marcrdavis/ArduinoTITO-PlayerTracking/Arduino TITO and TITO Deluxe Project - Documentation.pdf

June 23, 2026 – Version 4.0.20260623

# SETUP GUIDE

# Arduino TITO and TITO Deluxe

# Marc R. Davis

## OVERVIEW This is a TITO-only version of my larger project; re-designed for the Arduino UNO and as a compatible upgrade to the BETTORSlots TITO and

TITO Deluxe hardware.

## Project: https://github.com/marcrdavis/ArduinoTITO-PlayerTracking

ARDUINO TITO AND TITO DELUXE | 2

HARDWARE REQUIRED

Arduino UNO (or BETTORSlots TITO/Deluxe Board) https://www.amazon.com/gp/product/B01EWOE0UU

W5100 Ethernet Shield (if you want to use the Deluxe features) https://www.amazon.com/gp/product/B00AXVX5D0/

MAX3232 Serial port (or compatible)
https://www.amazon.com/gp/product/B083L99CGZ

1’ USB Cable
https://www.amazon.com/1-feet-USB-2-0-Printer-Device-Cable-Black-Type-A-Male-Type-B-Male-Plug-A-Male-to-B-Male-High/dp/B000JC00UO (https://www.amazon.com/1-feet-USB-2-0-Printer-Device-Cable-Black-Type-A-Male-Type-B-Male-Plug-A-Male-to-B-Male-High/dp/B000JC00UO)

Four 2” DuPont M-F jumper wires

CAT5 cable long enough to reach from your network jack to inside the game cabinet https://www.amazon.com//dp/B07QXNWRWJ (https://www.amazon.com/dp/B07QXNWRWJ)

Serial cable to connect to game

- For IGT Games: 5-pin Dupont to Male DB9 Serial pigtail (I reused the one from the BETTORSlots TITO board)
- https://www.amazon.com/gp/product/B081GJR1MN

5 Watt or greater USB Power Brick

3D printed case for Arduino (or something to protect Arduino from shorting-out on metal in cabinet)

Compatible slot machine

- Tested on IGT S2000/GameKings/AVP, Bally, WMS and Konami machines; will probably work on others based on the SAS 6.x protocol; you will need a compatible cable to connect to the serial port on the machine

SOFTWARE REQUIRED

Latest version of Arduino IDE https://www.arduino.cc/en/software

BEFORE YOU BEGIN

These instructions assume familiarity with electronics, coding and slot machine configurations. If you are new to any of these then this project may not be for you. My instructions were not written for beginners. You may damage your game or the Arduino/TITO hardware if you do not understand what you are doing.

WIRING (skip if reusing BETTORSlots hardware)

- The Ethernet Shield attaches to the Arduino UNO via the built-in pin headers [Deluxe Only]
- The Serial board needs to be wired as follows:
Serial | Arduino
VCC | 5V
RXD | Data Pin 0
TXD | Data Pin 1
GND | GND

You will need to power the Arduino board from the Accessory Outlet in the base of the slot machine using a USB power brick (5W or greater).

- Do not power the board from any built-in USB port on the game – it will not provide enough power

You will also need to run a CAT5 cable into the cabinet for the network.

INITIAL SETUP

- Assumes you have the Arduino IDE setup, the board and COM port settings are correct
- [Deluxe Only] The following libraries and versions are required:
- Ethernet* (latest)
- SPI* (latest)
- SD* (latest)

*Can be downloaded via the Arduino IDE Library Manager

- IMPORTANT: Before you program the Arduino, you must temporarily disconnect the two wires on serial pins 0 and 1 because the serial connection is shared between the USB and the 9-pin connector
- Connect the board to your computer via USB and load the ArduinoTITOV4 or ArduinoTITODeluxeV4 sketch as appropriate
- [Deluxe Only] The SD card is optional, but highly recommended; when present the board will attempt to read its configuration from the SD card. If the config.txt file is not present or if settings are missing the hard-coded defaults will be used.
- If you want to use the web UI then the SD card is required. Alternatively, you could control the machine from the Game Manager Windows app.
- [Deluxe Only with SD card] Format the MicroSD Card as FAT32
- [Deluxe Only with SD Card] Edit the included config.txt file with your settings and preferences; then copy it and the index.htm file to the SD card; see the Arduino TITO and Player Tracking Project - File Formats.txt for details on the supported parameters
- If you are using the TITO Only sketch or the Deluxe without an SD card, you must modify the following settings in the sketch before you download it to the Arduino UNO:
- ChangeToCredits – set to 1 to add credits via the Service/Change button
- changeCredits – set to the number of credits to add on each push of the Service/Change button
- [Deluxe Only] noSDCard – Set to 1 to disable the SD card, if present
- [Deluxe Only] mac – set a unique mac address for the Ethernet board; only necessary if you will be deploying more than one Arduino TITO Deluxe R3 board on your network
- [Deluxe Only] ip – set a unique IP address for your network
- Download the sketch to the Arduino; wait until complete
- Unplug the Arduino from the PC
- IMPORTANT: Re-attach the serial connections on pins 0 and 1
- Mount the hardware into the slot machine’s lower cabinet
- Connect the board to the game’s serial port using the DB9-to-DuPont cable or existing compatible cable
- [Deluxe Only] Connect the CAT5 Ethernet cable from your network switch to the Arduino
- Connect the USB power to the machine’s accessory outlet
- Power on the machine and test
- Assumes you are replacing an existing TITO board or have already setup your machine per the instructions later in this document

UPGRADING BETTORSLOTS HARDWARE

This software was designed to allow owners of the BETTORSlots TITO and TITO Deluxe hardware the option of upgrading their software to The Arduino TITO project.

WARNING! If you choose to upgrade your BETTORSlots board to The Arduino TITO Project software you do so at your own risk. The process is irreversible and you will lose any support, if any is still available, from the original vendor. I have only tested this on the few BETTORSlots boards I have in my possession.

The procedure is identical to the INITIAL SETUP process above; if you have a BETTORSlots Deluxe board then use the ArduinoTITODeluxe sketch; otherwise use the ArduinoTITO sketch.

REMOTE ACCESS (Deluxe Version Only)

The web interface allows you to control various aspects of your game by using a web browser.

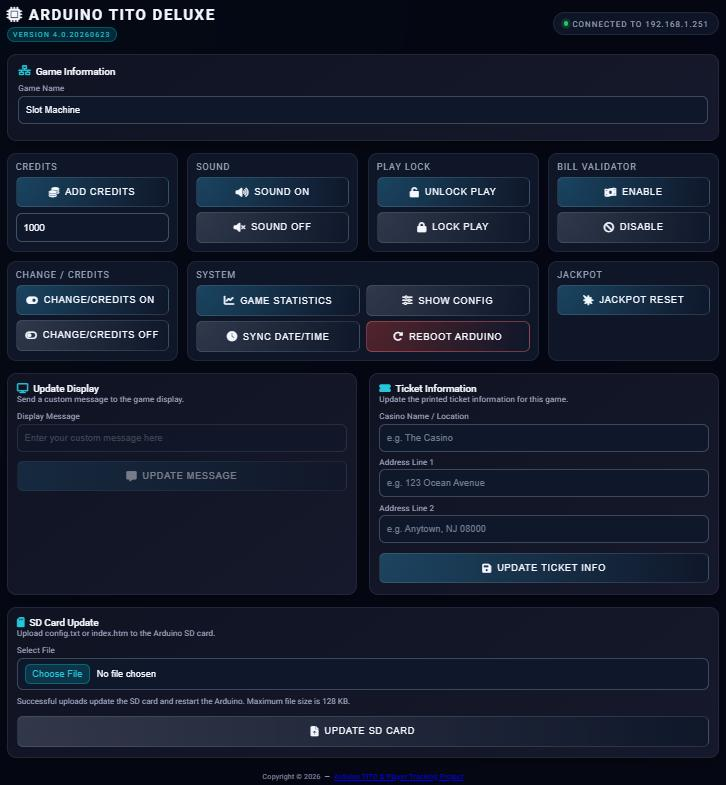
[picture p9: figure]

Most functions are self-explanatory; The Change/Credits feature allows you to enable adding credits by pressing the Change (or Service) button. The number of credits added on each press is set in the sketch (or the config file) prior to loading it onto the Arduino.

The Update Ticket Info option allows you to change the information printed on the cash-out ticket.

Some features are not available on all games or versions of the Arduino TITO board.

CONFIGURING YOUR IGT MACHINE (S2000/GameKing)

Before getting started with setting up your IGT machine for TITO please ensure your Bill Validator is working correctly and your Ticket Printer can print clear and legible tickets. You will also need a Keychip appropriate for your type of machine. These instructions assume familiarity with the Keychip process. Note – keychips and menu option locations vary from model-to-model. Please consult your IGT user manual or me if you have questions.

1. Clear any credits off your machine
2. Keychip your machine
3. Once in the Keychip Menu, ensure your Denomination, Devices, Limits and Game settings are as you want them
4. Setup the Comm Options as follows
a. IGT SAS Primary Channel = Channel 3
b. SAS Secondary = Off
c. Bally Miser = Off
d. Progressive Link = 7
e. WAMM 1.0 = Off
5. Setup the Validation/Redemption Options as follows
a. Validation = System Validation
b. Redemption = SAS Redemption
6. Setup the IGT SAS Options as follows
a. System Bonusing = SAS Legacy
7. Setup the SAS Channel (Primary Channel) Options as follows
a. Address = 1
b. Legacy Bonus = Enabled (X)
c. Validation = Enabled (X)
8. Setup the Machine Terminal Options as follows
a. Voucher Limit Follows = Credit Limit
9. Save all options and make any other changes you wish before pressing Return to Game to exit the keychip menu

Test the game by inserting money and then pressing Cash Out to generate a ticket. The ticket serial number should match the number of credits you inserted. Insert the ticket into the machine, it should accept it for the same number of credits.

CONFIGURING YOUR IGT MACHINE (AVP)

Please see this video for how to configure your AVP Game: https://www.youtube.com/watch?v=JKjyeFQPltA

NOTES AND COMMENTS

- This version was designed to create new TITO-only boards as well as upgrade or reuse existing BETTORSlots TITO and TITO Deluxe boards; if you choose to attempt to upgrade a BETTORSlots board you do so at your own risk and the process is irreversible.

DISCLAIMER

THIS SOFTWARE IS PROVIDED BY THE COPYRIGHT HOLDERS AND CONTRIBUTORS “AS IS” AND ANY EXPRESS OR IMPLIED WARRANTIES, INCLUDING, BUT NOT LIMITED TO, THE IMPLIED WARRANTIES OF MERCHANTABILITY AND FITNESS FOR A PARTICULAR PURPOSE ARE DISCLAIMED. IN NO EVENT SHALL THE COPYRIGHT OWNER OR CONTRIBUTORS BE LIABLE FOR ANY DIRECT, INDIRECT, INCIDENTAL, SPECIAL, EXEMPLARY, OR CONSEQUENTIAL DAMAGES (INCLUDING, BUT NOT LIMITED TO, PROCUREMENT OF SUBSTITUTE GOODS OR SERVICES; LOSS OF USE, DATA, OR PROFITS; OR BUSINESS INTERRUPTION) HOWEVER CAUSED AND ON ANY THEORY OF LIABILITY, WHETHER IN CONTRACT, STRICT LIABILITY, OR TORT (INCLUDING NEGLIGENCE OR OTHERWISE) ARISING IN ANY WAY OUT OF THE USE OF THIS SOFTWARE, EVEN IF ADVISED OF THE POSSIBILITY OF SUCH DAMAGE.

Figure 1 – Mockup

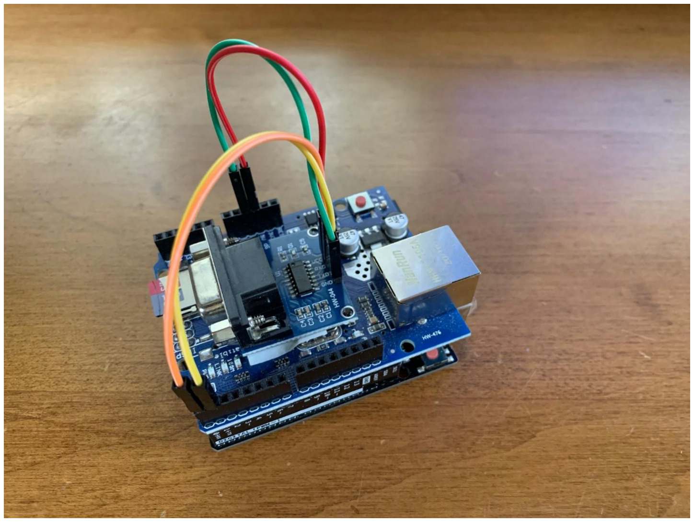
[picture p10: figure]

Example of Deluxe board wiring

FIGURE 2: IGT Serial Cable


IGT S2000/GameKing Serial Pinout

DB9 Male | Signal direction | S2000 J82
3 Receive Data | | 1 Transmit Data
2 Transmit Data | → | 2 Receive Data
5 Signal Ground | --- | 5 Signal Ground

Option: DB9 to Dupont Serial Cable: https://www.amazon.com/gp/product/B081GJR1MN
