marcrdavis/ArduinoTITO-PlayerTracking/(threads)

Thread 2 (2021-01-01):

Unable to TITO

Eddiiie, 2021-01-01:
I must be doing something wrong.

IGT G20, Mars BV

I have BettorTITO working.   Removed it, connected The ArduinoTITO-PlayerTracking System.   Followed the great instructions, created 2 played cards.  Boot up, comes online, insert ticket, long pause, spits ticket out.

Add some bonus credits using the WebUI and/or the RFID card, play a bit, hit cash out, long pause, hand pay.

Here are the logs collected from serial.....

**Ticket in**
```
SAS Event Received: 1F
SAS Event Received: 1F
SAS Event Received: 1F
SAS Event Received: 1F
SAS Event Received: 1F
SAS Event Received: 1F
SAS Event Received: 1F
SAS Event Received: 67
Unable to read data - timeout
Redeeming ticket
SAS Event Received: 51
SAS Event Received: 1F
SAS Event Received: 1F
SAS Event Received: 1F
SAS Event Received: 1F
SAS Event Received: 1F
```

**Ticket Out**
```
Arduino TITO and Player Tracking - Version 2.0 (Dec 22, 2020) By Marc R. Davis
Initializing...
IP address: 192.168.254.99
Initialization complete
Card Inserted
Card ID: 5727C4A6
Card Type: Player
Cardholder: Player1
Player Stats - Games played: 2 Games Won: 2 Games Lost: 0 Total Won: 2600
Reading meters from game
Unable to read data - timeout
Unable to read data - timeout
Unable to read data - timeout
Unable to read data - timeout
Unable to read data - timeout
Unable to read data - timeout
Could not read current stats from game. Player's current session will not be saved.
Ready for play
SAS Event Received: 51
SAS Event Received: 1F
SAS Event Received: 1F
SAS Event Received: 1F
SAS Event Received: 1F
SAS Event Received: 1F
SAS Event Received: 1F
SAS Event Received: 1F
SAS Event Received: 1F
SAS Event Received: 1F
SAS Event Received: 1F
SAS Event Received: 1F
SAS Event Received: 66
SAS Event Received: 57
Unable to read data - timeout
Printing cashout ticket
SAS Event Received: 57
Unable to read data - timeout
Printing cashout ticket
SAS Event Received: 57
Unable to read data - timeout
Printing cashout ticket
SAS Event Received: 57
Unable to read data - timeout
Printing cashout ticket
SAS Event Received: 57
Unable to read data - timeout
Printing cashout ticket
SAS Event Received: 57
Unable to read data - timeout
Printing cashout ticket
SAS Event Received: 57
Unable to read data - timeout
Printing cashout ticket
SAS Event Received: 57
Unable to read data - timeout
Printing cashout ticket
SAS Event Received: 51
SAS Event Received: 51
SAS Event Received: 51
```

marcrdavis, 2021-01-01:
Hi. Double check your Tito settings in the game to my instructions. It’s looks like something is wrong with the coms channel or the serial interface is having problems.

Also... what kind of game and software are you running?

Marc

Sent from my iPad

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

marcrdavis, 2021-01-01:
Took a look at the code and the log you sent; your machine is sending 1F – that is an unexpected (and possibly invalid) value). Normally the active SAS serial channel puts out a ‘heartbeat’ consisting of 0x80 and 0x81, yours seems to be sending 1F – which is not a valid response. A Long Poll of 01,1F by the host would cause the game to return the version number. But I don’t implement that in my code.

I think that the serial channel may be wrong. On Step 4A on Page 5 of the doc make sure the SAS channel is set to 3 and then in step 7A make sure it is set to 1. Then – goto the Diagnostics menu on the machine, open the Comm Channel Analyzer, select Com 3 and look at the data – at idle it should be series of 0x80 and 0x81 … send me a screen shot of what you are seeing there.

Marc

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

Eddiiie, 2021-01-02:
Hi,
My SASHost setup is on COM1.
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

On an AVP you have these daughter cards..  Fibre, RS232, Data Collection, etc.  I have my RS232 board in the slot for COM1.  Is the data exchanged different depending on which port it is coming from?    BettorTITO doesn't seem to care.

Could it be related to time?  There is a note in red that says the Protocol controlling Voucher In/Out will also control clock.

Here are some more screenshots -
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

Granted, there are a couple settings that are not set according to your recommendations.  Such as Progressive (Link 7 is not an option),

Is there a NOOP or something the program can respond to when it gets 1F?       If it was a communication issue wouldnt the other options not work?

marcrdavis, 2021-01-02:
Hi – I have not tested this on an AVP system or anything other than COM 3 – it is based on the same ports as the BETTORSlots board. Can you change your SAS port to COMM3?

Also – what type of game is this? It might help me understand what is going on. Thx

Marc

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

marcrdavis, 2021-01-02:
Well com1 may be correct; is everything setup as in this video: https://www.youtube.com/watch?v=JKjyeFQPltA

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

Eddiiie, 2021-01-02:
I moved to COM3.   In doing so I noticed one of the pins loose on the Serial adapter.   Fixed it and the 1F and 51 61 stuff has gone away.  In fact, the serial monitor window is pretty quiet after initializing and stuff.

Unfortunately, TITO is still not working.
 I swear I'd see a message about validating when inserting a ticket before..?  Now there is nothing.

Looking at the communication output in diagnostics, RX is 80, 81   TX is 0.  Most of the time.    I can't insert a ticket of course.
I DO have a serial port tapper to listen in on the conversation.

Also have WMS and Konami can test on.    It would be easier to move it to the other machines first.

Eddiiie, 2021-01-02:
Yes, everything is setup according to that video.  I can plug the BettorTITO in and TITO works fine.
The machine was setup with BettorTITO before plugging in the ArduinoTITO-PlayerTracking system.

Not sure if I mentioned I went back to COMM1 after testing COMM3.

Lemme try a couple other machines that are setup for BettorTITO in a few.

Eddiiie, 2021-01-02:
Hmmm Same thing on the Konami.
Everything seems to work except TITO.
I will experiment more tomorrow.

Did not test WMS

marcrdavis, 2021-01-02:
The RX is 80, 81 TX 0 is the normal idle state of the comm channel - so that’s good. The serial log on my app should be quiet except for when exceptions are thrown or long poll responses. The Tito commands are well documented and should work fine on your system. You say the other commands are working so that’s good.

This serial tap? What is that? Can you remove it?

Sent from my iPad

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

Eddiiie, 2021-01-02:
The serial tap is not connected.  Was just offering that up if we wanted to capture a ticket insert event and see what is going over the wire.

Will make a new board with TITO Only set to 1 tomorrow.

Where are the tito commands well documented?

Here is the tap -
[Serial Tap](https://www.amazon.com/Black-2-Port-RS232-Passive-Splitter/dp/B00AO9C38E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
)

marcrdavis, 2021-01-02:
If you can capture the ticket in and ticket out data using the working Tito board and send it to me that would be extremely helpful.

Sent from my iPad

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

Eddiiie, 2021-01-02:
Some IO Diag screenshots...
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

Eddiiie, 2021-01-02:
Will grab capture if Ticket In and Out of working tomorrow.
Thank you for your support!!

marcrdavis, 2021-01-02:
Make sure your config is back on COM1 – that appears to be the serial port on the AVP (S2000/GameKings use COM3)

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

marcrdavis, 2021-01-02:
https://studylib.net/doc/25224123/sas-602-protocol-manual

Section 15.7 for the cashout process

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

marcrdavis, 2021-01-02:
I have a theory as to why just the TITO is not working; send me your email address – I want to forward you a newer version of the code for testing. Thanks!

Marc

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

Closed 2021-01-13.

Thread 3 (2021-03-24):

Are you building the currently uploaded code?

jtwine, 2021-03-24:
Both versions of the code (magstripe or RFID) appear to have bugs that will prevent building _out of the box,_ I thought I was looking at a library/version issue, but there is code that just contains errors.  The `waitForResponse` function is a good example:

```
byte waitForResponse(byte & waitfor, byte * ret, int sz)
{
  byte responseBytes[sz - 2];
  int wait = 0;

  while (Serial1.read() != waitfor && wait < 3000) {
    delay(1);
    wait += 1;
  }

  if (wait >= 3000) {
    Serial.println(F("Unable to read data - timeout"));
    memset(ret, 0, sz);
    sasError = true;
    return ret;
  }

  Serial1.readBytes(responseBytes, sizeof(responseBytes));
  ret[0] = {0x01};
  ret[1] = waitfor;
  memcpy(ret + 2, responseBytes, sizeof(responseBytes));

  return ret;
}
```

The parameter `sz` is not constant and cannot be used to stack-allocate the `responseBytes` array.  The `ret` parameter is of type `byte*` but the code is trying to return it instead of a `byte`.  (That return value is not being used, anyway.)

There are other similar methods that look more like pesudocode than working C/C++.  In `setupPlayerMessage` this if statement is present: ``` if (playerComps>1 and !skipBuffer)``` - note the ```and``` instead of ```&&```.

Was there some post-download or pre-compile step that I need to perform that I missed?  Or was this just some accidental upload?

Thanks!

Peace!

-=- James.

marcrdavis, 2021-03-24:
Hi James – Hmm – you might be right about the setupPlayerMessage code – but it is compiling and working on my side – very odd. I will fix that.

The waitForResponse code is working fine though and the code does compile.

You will get compile warnings (if you have them enabled) but the code will compile fine. I have had multiple folks testing both versions for a few weeks now on different games and everything has been fine.

Marc

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

marcrdavis, 2021-03-24:
Regarding the waitForResponse code; sz is not a constant; the responseBytes array is sized differently depending on the size of the input array, less two bytes.

Yes - the return is not being used; It could probably be rewritten more elegantly. That function went through several revisions and I may have just left the declaration unmodified.

jtwine, 2021-03-25:
Can you tell me which environment/toolchain you are using to build this?  Whichever one is compiling the code as-is correctly?  (Unless I missed it in the Wiki/Readme/Docs?)

Thanks!

Peace!

-=- James.

marcrdavis, 2021-03-25:
I’m using the Arduino IDE version 1.8.13;

Be sure to update your \Libraries folder with the modified libraries included in the zip file.

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

jtwine, 2021-03-25:
OK - I see what my problem is.  A non-constant array size (VLA) is an _optional_ feature of C11 that is supported by GCC but not all compilers.   That is why that code was tripping me up.  I would have implemented the same kind of behavior using `alloca(...)`, which is not available on all platforms, but this is essentially the same thing.

This, BTW, is the same reason `and` works in the `if` expression - `and` is an alternative token for `&&` that is supported by some C++ compilers (like GCC).

Thanks and sorry for my confusion.

Peace!

-=- James.

marcrdavis, 2021-03-25:
I’m going to cleanup the warnings in the next release. Thx

Marc

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

Closed 2021-03-25.

Thread 5 (2021-12-05):

Konami Support?

samm329b, 2021-12-05:
So far I have tried this out with WMS, Bally, and IGT having no issues, but the unit does not work with konami? Any chance you plan to add support for Konami?

marcrdavis, 2021-12-05:
Hi samm329b - As I don't own a konami it would be hard to test and develop for. Most devices based on the SAS V6 protocol should work; I am guessing Konami is different. If there is any documentation on the protocol they are using I'd be happy to take a look.

marcrdavis, 2021-12-05:
I have reports that is is working with Konami K2V, KP3 and Selixicon.

samm329b, 2021-12-06:
Hello and thanks for the response. I have it plugged into a Konami k2v unit I’m testing with, I turned on the tilt mode for the communications when the credits were not adding, once I turned on the comm tilt about ever 3 seconds like clock work the machine would beep (like a door open beep) and the unit would said lost comm to the host. I have moved the unit over to a few other cabinets to confirm the tito is working fine, so I figured it had to be something within the delay commands in the code, I adjusted them and each time the same result, no beeping just a solid communication with host lost, so I reverted back to the original setting, and I’m back to where I started.

samm329b, 2021-12-06:
I’d like to tell you the fix… smh. I had a bad ground in my Konami cable to the backplane. Works like a charm!

marcrdavis, 2021-12-06:
Cool - thanks for letting me know; glad you got it working!

Closed 2021-12-06.

Thread 6 (2022-01-21):

Arduino UNO SD Fail

josnav, 2022-01-21:
Hi!!! Testing your code ArduinoTITODeluxe, I got "Failed to read config.txt". If I remove code and let more free memory, then it reads config.txt.
I'm using Arduino Uno R3...

Can you export that sample to Mega?

Thanks

marcrdavis, 2022-01-23:
HI - That code was tested and is working with the R3; running it on 3 devices right now; if you are running out of memory then one of two things probably happened - you added code or one or more included libraries are not at the right versions; example - the Ethernet library must be set to version 1.0.4 (page 4 of doc) otherwise there is insufficient memory for the sketch.

The deluxe sketch has virtually no free ram left; if you are looking for something to play with or you want just the TITO functionality on the MEGA, then please use my other sketch in the main project and then you can use the onlyTITO flag to disable the player tracking stuff.

Marc

Closed 2022-01-25.

Thread 7 (2022-11-08):

Qué tal si tratamos de este proyecto adaptarlo a una esp32?

juanclavel, 2022-11-08:

marcrdavis, 2022-11-15:
I am considering it.

juanclavel, 2022-11-15:
thank you very much it would be easier to carry out this excellent project

Obtener Outlook para iOS<https://aka.ms/o0ukef>
________________________________
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

Closed 2022-11-15.

Thread 8 (2023-02-28):

SAS adapter?

philfry9, 2023-02-28:
Hi Marc,

Thanks for sharing this project. I just acquired my first machine and am in the process of getting this setup now.
I think I have everything set with one exception. The machine did not have BS-TITO previously. I have the recommended serial connector connected to the Arduino. I would like to build an adapter from the serial output of the Arduino (RS232 to TTL Converter Module COM Serial Port Board) into the SAS port on the comms panel. I have looked t the schematics for that port (from NLG forums) but cannot seem to get a proper connection from the Arduino system to the comms panel to receive inputs.

Any chance you could provide a quick wiring/pinout explanation for my to build a connection from the serial expansion board to the SAS port? Eg: Can I wire from the 5-pin SAS into the serial port directly?

Appreciate any help.

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

philfry9, 2023-02-28:
Thought to look at the pinout for RS232 protocol. Going to try matching this....
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

marcrdavis, 2023-02-28:
Hi Phillip,

Thanks for writing. I am a little confused, I think what you are looking to do is documented on page 22 of the manual. It describes the pinout of the J82 connector on the IGT S2000/GameKing and how to wire it to a 9-pin male serial connection using a DB9 to Dupont Serial cable: https://www.amazon.com/gp/product/B081GJR1MN

Please take a look at let me know if that is what you needed.

Marc

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

philfry9, 2023-02-28:
Absolutely correct. I have read that manual probably 5 times and have no idea how I missed it. Much appreciated!

Closed 2023-02-28.
