marcrdavis/ArduinoTITO-PlayerTracking/ArduinoTITODeluxe/SD Card Files/config.txt

changeToCredits=0
changeCredits=200
noSDCard=0
ipAddress=
macAddress=
gameName=Slot Machine
