marcrdavis/ArduinoTITO-PlayerTracking/ArduinoTITODeluxeR4WiFi/SD Card Files/config.txt

logToSerial=1
changeToCredits=0
changeCredits=200
noSDCard=0
useDHCP=1
ipAddress=
wifiSSID=
wifiPassword=
gameName=Slot Machine
