marcrdavis/ArduinoTITO-PlayerTracking/ArduinoTITODeluxeR4WiFi/UNO R4 WiFi 9-Bit Serial/Serial.cpp

/*
  Serial.cpp - wrapper over mbed RawSerial
  Part of Arduino - http://www.arduino.cc/

  Copyright (c) 2018-2019 Arduino SA

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
  You should have received a copy of the GNU Lesser General
  Public License along with this library; if not, write to the
  Free Software Foundation, Inc., 59 Temple Place, Suite 330,
  Boston, MA  02111-1307  USA
*/

#include "Arduino.h"
#include "Serial.h"
#include "IRQManager.h"


#ifdef Serial
#undef Serial
#endif

UART * UART::g_uarts[MAX_UARTS] = {nullptr};

void uart_callback(uart_callback_args_t __attribute((unused)) *p_args)
{
    /* This callback function is not used but it is referenced into 
       FSP configuration so that (for the moment it is necessary to keep it) */
}

/* -------------------------------------------------------------------------- */
void UART::WrapperCallback(uart_callback_args_t *p_args) {
/* -------------------------------------------------------------------------- */  

  uint32_t channel = p_args->channel;
  
  UART *uart_ptr = UART::g_uarts[channel];

  if(uart_ptr == nullptr) {
    return;
  }
  

  switch (p_args->event){
      case UART_EVENT_ERR_PARITY:
      case UART_EVENT_ERR_FRAMING:
      case UART_EVENT_ERR_OVERFLOW:
      case UART_EVENT_RX_COMPLETE: // This is called when all the "expected" data are received
      {
          break;
      }
      case UART_EVENT_TX_COMPLETE:
      case UART_EVENT_TX_DATA_EMPTY:
      {
        //uint8_t to_enqueue = uart_ptr->txBuffer.available() < uart_ptr->uart_ctrl.fifo_depth ? uart_ptr->txBuffer.available() : uart_ptr->uart_ctrl.fifo_depth;
        //while (to_enqueue) {
        uart_ptr->tx_done = true;
        break;
      }
      case UART_EVENT_RX_CHAR:
      {
        if (uart_ptr->rxBuffer.availableForStore()) {
          uart_ptr->rxBuffer.store_char(p_args->data);
        }
        break;
      }
      case UART_EVENT_BREAK_DETECT:
      {
          break;
      }
  }

}


UART::UART(int _pin_tx, int _pin_rx, int _pin_rts, int _pin_cts):
  tx_pin(_pin_tx),
  rx_pin(_pin_rx),
  rts_pin(_pin_rts),
  cts_pin(_pin_cts),
  init_ok(false) {
/* -------------------------------------------------------------------------- */    
  uart_cfg.txi_irq = FSP_INVALID_VECTOR;
  uart_cfg.tei_irq = FSP_INVALID_VECTOR;
  uart_cfg.rxi_irq = FSP_INVALID_VECTOR;
  uart_cfg.eri_irq = FSP_INVALID_VECTOR;
}

/* -------------------------------------------------------------------------- */
bool UART::setUpUartIrqs(uart_cfg_t &cfg) {
/* -------------------------------------------------------------------------- */  
  bool rv = false;

  rv = IRQManager::getInstance().addPeripheral(IRQ_SCI_UART,&cfg);
  
  return rv;
} 

/* -------------------------------------------------------------------------- */
size_t UART::write(uint8_t c) {
/* -------------------------------------------------------------------------- */  
  if(init_ok) {
    tx_done = false;
    R_SCI_UART_Write(&uart_ctrl, &c, 1);
    while (!tx_done) {}
    return 1;
  }
  else {
    return 0;
  }
}

size_t  UART::write(uint8_t* c, size_t len) {
  if(init_ok) {
    tx_done = false;
    R_SCI_UART_Write(&uart_ctrl, c, len);
    while (!tx_done) {}
    return len;
  }
  else {
    return 0;
  }
}

/* -------------------------------------------------------------------------- */
UART::operator bool() {
/* -------------------------------------------------------------------------- */  
	return true;
}

/* -------------------------------------------------------------------------- */
bool  UART::cfg_pins(int max_index) {
/* -------------------------------------------------------------------------- */  
  /* verify index are good */
  if(tx_pin < 0 || rx_pin < 0 || tx_pin >= max_index || rx_pin >= max_index) {
    return false;
  }
  /* getting configuration from table */
  auto cfgs_tx = getPinCfgs(tx_pin, PIN_CFG_REQ_UART_TX);
  auto cfgs_rx = getPinCfgs(rx_pin, PIN_CFG_REQ_UART_RX);

  uint16_t cfg_tx = 0;
  uint16_t cfg_rx = 0;

  /* Find the best combination */
  for (size_t i = 0; i < cfgs_tx.size(); i++) {
    for (size_t j = 0; j < cfgs_rx.size(); j++) {
      if (cfgs_tx[i] && cfgs_rx[i] && GET_CHANNEL(cfgs_tx[i]) == GET_CHANNEL(cfgs_rx[j])) {
        cfg_tx = cfgs_tx[i];
        cfg_rx = cfgs_rx[j];
        channel = GET_CHANNEL(cfg_tx);
        goto done;
      }
    }
  }

done:
  /* verify configuration are good */
  if(cfg_tx == 0 || cfg_rx == 0 ) {
    return false;
  }

  /* verify channel does not exceed max possible uart channels */
  if(channel >= MAX_UARTS) {
    return false;
  }
  /* setting channel */
  channel = GET_CHANNEL(cfg_tx);
  
  /* actually configuring PIN function */
  ioport_peripheral_t ioport_tx = USE_SCI_EVEN_CFG(cfg_tx) ? IOPORT_PERIPHERAL_SCI0_2_4_6_8 : IOPORT_PERIPHERAL_SCI1_3_5_7_9;
  ioport_peripheral_t ioport_rx = USE_SCI_EVEN_CFG(cfg_rx) ? IOPORT_PERIPHERAL_SCI0_2_4_6_8 : IOPORT_PERIPHERAL_SCI1_3_5_7_9;

  R_IOPORT_PinCfg(&g_ioport_ctrl, g_pin_cfg[tx_pin].pin, (uint32_t) (IOPORT_CFG_PERIPHERAL_PIN | ioport_tx));
  R_IOPORT_PinCfg(&g_ioport_ctrl, g_pin_cfg[rx_pin].pin, (uint32_t) (IOPORT_CFG_PERIPHERAL_PIN | ioport_rx));
  if (rts_pin != -1 && cts_pin != -1) {
    // hopefully people using flow control have read the datasheet so let's avoid the double check
    R_IOPORT_PinCfg(&g_ioport_ctrl, g_pin_cfg[rts_pin].pin, (uint32_t) (IOPORT_CFG_PERIPHERAL_PIN | ioport_rx));
    R_IOPORT_PinCfg(&g_ioport_ctrl, g_pin_cfg[cts_pin].pin, (uint32_t) (IOPORT_CFG_PERIPHERAL_PIN | ioport_rx));
  }

  return true;
}

/* -------------------------------------------------------------------------- */
void UART::begin(unsigned long baudrate, uint16_t config) {
/* -------------------------------------------------------------------------- */  
  int max_index = PINS_COUNT;

  init_ok = cfg_pins(max_index);
  
  if(init_ok) {
    UART::g_uarts[channel]        = this;

    uart_baud.semr_baudrate_bits_b.abcse          = 0;
    uart_baud.semr_baudrate_bits_b.abcs           = 0;
    uart_baud.semr_baudrate_bits_b.bgdm           = 1;
    uart_baud.cks                                 = 0;
    uart_baud.brr                                 = 25;
    uart_baud.mddr                                = (uint8_t) 256;
    uart_baud.semr_baudrate_bits_b.brme           = false;

    uart_cfg_extend.clock                         = SCI_UART_CLOCK_INT;
    uart_cfg_extend.rx_edge_start                 = SCI_UART_START_BIT_FALLING_EDGE;
    uart_cfg_extend.noise_cancel                  = SCI_UART_NOISE_CANCELLATION_DISABLE;
    uart_cfg_extend.rx_fifo_trigger               = SCI_UART_RX_FIFO_TRIGGER_MAX;
    uart_cfg_extend.p_baud_setting                = &uart_baud;
    uart_cfg_extend.flow_control                  = SCI_UART_FLOW_CONTROL_RTS;
    uart_cfg_extend.flow_control_pin              = (bsp_io_port_pin_t) UINT16_MAX;
    if (rts_pin != -1 && cts_pin != -1) {
      uart_cfg_extend.flow_control                  = SCI_UART_FLOW_CONTROL_HARDWARE_CTSRTS;
    }
    uart_cfg_extend.rs485_setting.enable          = SCI_UART_RS485_DISABLE;
    uart_cfg_extend.rs485_setting.polarity        = SCI_UART_RS485_DE_POLARITY_HIGH;
    uart_cfg_extend.rs485_setting.de_control_pin  = (bsp_io_port_pin_t) UINT16_MAX;
    
    uart_cfg.channel                              = channel; 
    uart_cfg.p_context                            = NULL;
    uart_cfg.p_extend                             = &uart_cfg_extend;
    uart_cfg.p_transfer_tx                        = NULL;
    uart_cfg.p_transfer_rx                        = NULL;
  
    switch(config){
      case SERIAL_8N1:
          uart_cfg.data_bits = UART_DATA_BITS_8;
          uart_cfg.parity = UART_PARITY_OFF;
          uart_cfg.stop_bits = UART_STOP_BITS_1;
          break;
      case SERIAL_8N2:
          uart_cfg.data_bits = UART_DATA_BITS_8;
          uart_cfg.parity = UART_PARITY_OFF;
          uart_cfg.stop_bits = UART_STOP_BITS_2;
          break;
      case SERIAL_8E1:
          uart_cfg.data_bits = UART_DATA_BITS_8;
          uart_cfg.parity = UART_PARITY_EVEN;
          uart_cfg.stop_bits = UART_STOP_BITS_1;
          break;
      case SERIAL_8E2:
          uart_cfg.data_bits = UART_DATA_BITS_8;
          uart_cfg.parity = UART_PARITY_EVEN;
          uart_cfg.stop_bits = UART_STOP_BITS_2;
          break;
      case SERIAL_8O1:
          uart_cfg.data_bits = UART_DATA_BITS_8;
          uart_cfg.parity = UART_PARITY_ODD;
          uart_cfg.stop_bits = UART_STOP_BITS_1;
          break;
      case SERIAL_8O2:
          uart_cfg.data_bits = UART_DATA_BITS_8;
          uart_cfg.parity = UART_PARITY_ODD;
          uart_cfg.stop_bits = UART_STOP_BITS_2;
          break;
      case SERIAL_9N1:
           uart_cfg.data_bits = UART_DATA_BITS_9;
           uart_cfg.parity = UART_PARITY_OFF;
           uart_cfg.stop_bits = UART_STOP_BITS_1;
           break;
    }
    
    uart_cfg.p_callback = UART::WrapperCallback;
  }
  else {
    return;
  }

  init_ok &= setUpUartIrqs(uart_cfg);
  
  fsp_err_t err;
  const bool bit_mod = true;
  const uint32_t err_rate = 3000; //means 3%

  err = R_SCI_UART_BaudCalculate(baudrate, bit_mod, err_rate, &uart_baud);
  if (uart_baud.mddr == 0) {
    err = R_SCI_UART_BaudCalculate(baudrate, false, err_rate, &uart_baud);
  }
  err = R_SCI_UART_Open (&uart_ctrl, &uart_cfg);
  if(err != FSP_SUCCESS) while(1);
  err = R_SCI_UART_BaudSet(&uart_ctrl, (void *) &uart_baud);
  if(err != FSP_SUCCESS) while(1);

  rxBuffer.clear();
  txBuffer.clear();
}

/* -------------------------------------------------------------------------- */
void UART::begin(unsigned long baudrate) {
/* -------------------------------------------------------------------------- */  
  begin(baudrate, SERIAL_8N1);
}

/* -------------------------------------------------------------------------- */
void UART::end() {
/* -------------------------------------------------------------------------- */  
  rxBuffer.clear();
  txBuffer.clear();
  R_SCI_UART_Close (&uart_ctrl);
}

/* -------------------------------------------------------------------------- */
int UART::available() {
/* -------------------------------------------------------------------------- */  
  return rxBuffer.available();
}

/* -------------------------------------------------------------------------- */
int UART::peek() {
/* -------------------------------------------------------------------------- */  
  return rxBuffer.peek();
}

/* -------------------------------------------------------------------------- */
int UART::read() {
/* -------------------------------------------------------------------------- */  
  return  rxBuffer.read_char();
}

/* -------------------------------------------------------------------------- */
void UART::flush() {
/* -------------------------------------------------------------------------- */  
  while(txBuffer.available());
}

/* -------------------------------------------------------------------------- */
size_t UART::write_raw(uint8_t* c, size_t len) {
/* -------------------------------------------------------------------------- */
  size_t i = 0;
  while (i < len) {
    uart_ctrl.p_reg->TDR = *(c+i);
    while (uart_ctrl.p_reg->SSR_b.TEND == 0) {}
    i++;
  }
  return len;
}
