marcrdavis/ArduinoTITO-PlayerTracking/(commit log)

2021-03-24 Update ArduinoPlayerTrackingV2MAG.ino
    Bug in line 389 - had function disabled for testing on mockup
2021-05-24 Experimental Camera Support
    [config.txt]
2021-10-31 Version 2.0.20211031
    Adds support for Arduino UNO TITO and TITO Deluxe
    [config.txt]
2022-03-30 Update Arduino TITO and Player Tracking Project - File Formats.txt
    Fixed typo in line 49
2026-06-21 Version 3.1.20260619
    Adds updated webUI to all active projects; minor code changes
    [config.txt]
2026-06-21 Reverted back to previous versions
    [ArduinoPlayerTrackingV3.ino, ArduinoPlayerTrackingV3Wifi.ino, ArduinoTITODeluxeR4Wifi.ino, ArduinoTITODeluxeV3.ino, ArduinoTITOV3.ino]
